mikewen/virtual-sense.dsp-hardware/AudioDSP/distinct_VS_ADSP.ods

Components | Quantity | To mount | Package | Value | Note
BTB1 | 1 | NO | Through Hole | KEYSTONE – 2466 | http://it.farnell.com/keystone/2466/battery-holder/dp/1702632
R41,R40 | 2 | NO | Resistor SMD 0603 | 10K
R49 | 1 | NO | Resistor SMD 0603 | 0
C16,C12,C10,C14 | 4 | NO | Capacitor ceramic SMD 0603 | 10u
C69 | 1 | NO | Radial Can – SMD | 100u | http://it.farnell.com/panasonic/eeeft0j101ar/cap-alu-elec-100uf-6-3v-smd/dp/2065951
P1,P6 | 2 | NO | Through Hole Headers 2x1 | TE Connectivity 2-1445098-2 | http://it.mouser.com/ProductDetail/TE-Connectivity/2-1445098-2/
P15 | 1 | NO | Through Hole Headers 6x1 | Molex 53014-0610 | http://www.molex.com/molex/products/listview.jsp?query=&offset=0&autoNav=1&sType=z&filter=&channel=Products
P16 | 1 | NO | Through Hole Headers 8x1 | Molex 53014-0810 | http://www.molex.com/molex/products/listview.jsp?query=&offset=0&autoNav=1&sType=z&filter=&channel=Products
P17,P18 | 2 | NO | Through Hole Headers 4x1 | Molex 53014-0410 | http://www.molex.com/molex/products/listview.jsp?query=&offset=0&autoNav=1&sType=z&filter=&channel=Products
P3,P4,P5 | 3 | NO | Through Hole Headers 2x1 | Molex 53014-0210 | http://www.molex.com/molex/products/listview.jsp?query=&offset=0&autoNav=1&sType=z&filter=&channel=Products
BTB2 | 1 | YES | Coin Cell Holder – 7.9mm | KEYSTONE – 2988 | http://it.farnell.com/keystone/2988/battery-contact-7-9mm-hear-aid/dp/1887934
C17,C2,C11,C41,C43,C30,C59,C58,C52,C53,C21,C7 | 12 | YES | Capacitor ceramic SMD 0805 | 10u
C18 | 1 | YES | Capacitor ceramic SMD 0805 | 4u7
C20,C1,C15,C29,C24,C26,C34,C36,C35,C61,C60,C65,C70,C48,C39,C8,C13,C66,C55,C56,C22,C19,C9,C44,C46,C33,C31,C38,C47,C45 | 30 | YES | Capacitor ceramic SMD 0603 | 100n
C25,C32,C67,C68,C40,C42 | 6 | YES | Capacitor ceramic SMD 0805 | 1u
C27,C28 | 2 | YES | Capacitor ceramic SMD 0603 | 33p
C37 | 1 | YES | Capacitor ceramic SMD 0603 | 10n
C4,C3,C6,C5 | 4 | YES | Capacitor ceramic SMD 0603 | 470n
C49,C50 | 2 | YES | Radial Can – SMD | 100u | http://it.farnell.com/panasonic/eeeft0j101ar/cap-alu-elec-100uf-6-3v-smd/dp/2065951
C51,C64 | 2 | YES | Capacitor ceramic SMD 1210 | 22u
C63,C62 | 2 | YES | Capacitor ceramic SMD 1206 | 2u2
D0,D1 | 2 | YES | LED SMD 0603 | 150060RS75000 - RED | http://katalog.we-online.de/led/datasheet/150060RS75000.pdf
D5 | 1 | YES | SOD-80 | ZMM5234B-7-F | http://it.mouser.com/ProductDetail/Vishay-Semiconductors/TZM5234B-GS08/
L1,L2 | 2 | YES | Inductor SMD 0805 | BLM21AG151SN1D
L12,L10,L11,L9 | 4 | YES | Inductor SMD 0805 | BLM21BB221SN1D
L3 | 1 | YES | Inductor SMD 0805 | BLM18AG601SN1D
L7,L6,L4,L8,L5 | 5 | YES | Inductor SMD 0603 | BLM18AG601SN1D
PB1,PB2,PB3 | 3 | YES | SMD Push Button | FSM2JSMA | http://it.mouser.com/ProductDetail/TE-Connectivity-Alcoswitch/FSM2JSMA/
R11,R14 | 2 | YES | Resistor SMD 0603 | 300
R23,R18,R20 | 3 | YES | Resistor SMD 0603 | 100K
R3,R13 | 2 | YES | Resistor SMD 0603 | 4K7
R31,R34,R33,R37,R39,R43,R45,R47,R36,R38,R42,R44,R46,R55,R57,R2,R17,R21,R22,R24,R19 | 21 | YES | Resistor SMD 0603 | 10K
R5,R4,R8,R6 | 4 | YES | Resistor SMD 0603 | 1K
R51,R50 | 2 | YES | Resistor SMD 0805 | 0
R54,R25,R48,R30,R26,R15,R58,R29,R1,R10,R9,R7 | 12 | YES | Resistor SMD 0603 | 0
R56,R27 | 2 | YES | Resistor SMD 0603 | 220
SD2,SD1 | 2 | YES | MCH_FCI-10067847-001 | FCI-10067847-001 | http://portal.fciconnect.com/Comergent//fci/drawing/10067847.pdf
SW1 | 1 | YES | Slide switch Through Hole | JS202011CQN | http://it.mouser.com/ProductDetail/CK-Components/JS202011CQN/
SW2 | 1 | YES | Slide switch SMD | JS202011SCQN | http://it.mouser.com/ProductDetail/CK-Components/JS202011SCQN/
U1 | 1 | YES | SOT23-5 | TPS76933 | http://it.farnell.com/texas-instruments/tps76933dbvt/ic-ldo-regulator-0-1a-10v-sot23/dp/8461538
U10 | 1 | YES | SOIC-8 (15mil Body Width) | SST25PF080B-80-4C-SAE | http://it.mouser.com/ProductDetail/Microchip-Technology/SST25PF080B-80-4C-SAE/
U13 | 1 | YES | OLed Through Hole | MIDAS – 2063209 | http://it.farnell.com/midas/mccog21605b6w-bnmlwi/lcd-cog-2x16-neg-stn-w-b-l-i2c/dp/2063209
U2 | 1 | YES | QFN-N32 | TLV320AIC3204 | http://it.farnell.com/texas-instruments/tlv320aic3204irhbt/ic-lp-audio-codec-1-8v-32qfn/dp/1689424
U3 | 1 | YES | DFN-6 | SI7020 | http://it.mouser.com/ProductDetail/Silicon-Labs/Si7020-A10-GM/
U4 | 1 | YES | 2.5 mm x 2 mm | ASDM1-12.000MHZ | http://it.mouser.com/ProductDetail/ABRACON/ASDM1-12000MHZ-LC-T/
U5 | 1 | YES | BGA-N144 | TMS320C5535AZHH10 | http://it.farnell.com/texas-instruments/tms320c5535azhh10/ic-dsp-c55x-fixed-point-144bga/dp/2076772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
U7 | 1 | YES | SOIC-8 | TPS77533D | http://it.mouser.com/ProductDetail/Texas-Instruments/TPS77533D/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
U8 | 1 | YES | SOIC | TPS2080D | http://it.farnell.com/texas-instruments/tps2080d/ic-dual-power-dist-sw-8-soic/dp/1755538?Ntt=tps2080d
U9 | 1 | YES | HTSSOP-20 EP | TPS60125PWP | http://it.mouser.com/ProductDetail/Texas-Instruments/TPS60125PWP/
USB1 | 1 | YES | micro USB SMD Connector | 10103594-0001LF | http://it.mouser.com/ProductDetail/FCI/10103594-0001LF/
X1 | 1 | YES | 4115 | DST410S 32.768KHz | http://www.compotek.de/fileadmin/data/Datenblaetter/DST410S-32.768k-9-20-E.pdf
