mikewen/virtual-sense.dsp-hardware/AudioDSP/distinct_VS-Idro.ods

Component | Quantity | Package | Value | Note
BTB2 | 1 | Coin Cell Holder - 7.9mm | KEYSTONE – 2988 | http://it.farnell.com/keystone/2988/battery-contact-7-9mm-hear-aid/dp/1887934
C1,C8,C9,C13,C15,C19,C20,C22,C24,C26,C29,C31,C33,C34,C35,C36,C38,C39,C44,C45,C46,C47,C48,C55,C56,C57,C60,C61,C65,C66,C70 | 31 | Capacitor ceramic SMD 0603 | 100n
C2,C7,C11,C17,C21,C30,C41,C43,C52,C53,C54,C58,C59 | 13 | Capacitor ceramic SMD 0805 | 10u
C3,C4,C5,C6 | 4 | Capacitor ceramic SMD 0603 | 470n
C10,C12,C14,C16,R40,R41,R49 | 7 | Capacitor ceramic SMD 0603 | NO
C18,C23 | 2 | Capacitor ceramic SMD 0805 | 4u7
C25,C32,C40,C42,C67,C68 | 6 | Capacitor ceramic SMD 0805 | 1u
C27,C28 | 2 | Capacitor ceramic SMD 0603 | 33p
C37 | 1 | Capacitor ceramic SMD 0603 | 10n
C49,C50 | 2 | Radial Can – SMD | 100u | http://it.farnell.com/panasonic/eeeft0j101ar/cap-alu-elec-100uf-6-3v-smd/dp/2065951
C51,C64 | 2 | Capacitor ceramic SMD 1210 | 22u
C62,C63 | 2 | Capacitor ceramic SMD 1206 | 2u2
C69 | 1 | Radial Can – SMD | NO
D0,D1 | 2 | LED SMD 0603 | 150060RS75000 - RED | http://katalog.we-online.de/led/datasheet/150060RS75000.pdf
D5 | 1 | SOD-80 | ZMM5234B-7-F | http://it.mouser.com/ProductDetail/Vishay-Semiconductors/TZM5234B-GS08/
L1,L2 | 2 | Inductor SMD 0805 | BLM21AG151SN1D
L3,L4,L5,L6,L7,L8 | 6 | Inductor SMD 0805 | BLM18AG601SN1D
L9,L10,L11,L12 | 4 | Inductor SMD 0805 | BLM21BB221SN1D
PB1,PB2,PB3 | 3 | SMD Pushbutton | FSM2JSMA | http://it.mouser.com/ProductDetail/TE-Connectivity-Alcoswitch/FSM2JSMA/
R1,R7,R9,R10,R12,R15,R25,R26,R29,R30,R35,R48,R50,R51,R54,R58 | 16 | Resistor SMD 0603 | 0
R2,R17,R19,R21,R22,R24,R31,R33,R34,R36,R37,R38,R39,R42,R43,R44,R45,R46,R47,R55,R57 | 21 | Resistor SMD 0603 | 10K
R3,R13 | 2 | Resistor SMD 0603 | 4K7
R4,R5,R6,R8 | 4 | Resistor SMD 0603 | 1K
R11,R14 | 2 | Resistor SMD 0603 | 300
R18,R20,R23 | 3 | Resistor SMD 0603 | 100K
R27,R56 | 2 | Resistor SMD 0603 | 220
SD1,SD2 | 2 | MCH_FCI-10067847-001 | FCI-10067847-001 | http://portal.fciconnect.com/Comergent//fci/drawing/10067847.pdf
SW1,SW2 | 2 | JS202011SCQN | JS202011SCQN | http://it.mouser.com/ProductDetail/CK-Components/JS202011SCQN/
U1 | 1 | SOT23-5 | TPS76933 | http://it.farnell.com/texas-instruments/tps76933dbvt/ic-ldo-regulator-0-1a-10v-sot23/dp/8461538
U2 | 1 | QFN-N32 | TLV320AIC3204 | http://it.farnell.com/texas-instruments/tlv320aic3204irhbt/ic-lp-audio-codec-1-8v-32qfn/dp/1689424
U3 | 1 | DFN-6 | SI7020 | http://it.mouser.com/ProductDetail/Silicon-Labs/Si7020-A10-GM/
U4 | 1 | 2.5 mm x 2 mm | ASDM1-12.000MHZ | http://it.mouser.com/ProductDetail/ABRACON/ASDM1-12000MHZ-LC-T/
U5 | 1 | BGA-N144 | TMS320C5535AZHH10 | http://it.farnell.com/texas-instruments/tms320c5535azhh10/ic-dsp-c55x-fixed-point-144bga/dp/2076772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
U7 | 1 | SOIC-8 | TPS77533D | http://it.mouser.com/ProductDetail/Texas-Instruments/TPS77533D/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
U8 | 1 | SOIC | TPS2080D | http://it.farnell.com/texas-instruments/tps2080d/ic-dual-power-dist-sw-8-soic/dp/1755538?Ntt=tps2080d
U9 | 1 | HTSSOP-20 EP | TPS60125PWP | http://it.mouser.com/ProductDetail/Texas-Instruments/TPS60125PWP/
U10 | 1 | SOIC-8 | SST25PF080B-80-4C-S2AE | http://it.mouser.com/ProductDetail/Microchip-Technology/SST25PF080B-80-4C-S2AE/
U11 | 1 | TH | 1144435 | http://it.farnell.com/fci/10018783-11110tlf/connettore-pci-2x18-vie/dp/1144435?Ntt=1144435
U13 | 1 | TH | 2063209 | http://it.farnell.com/midas/mccog21605b6w-bnmlwi/lcd-cog-2x16-neg-stn-w-b-l-i2c/dp/2063209
USB1 | 1 | micro USB connector | 10118194-0001LF | http://it.mouser.com/ProductDetail/FCI/10118194-0001LF/
X1 | 1 | 4115 | DST410S 32.768KHz | http://www.compotek.de/fileadmin/data/Datenblaetter/DST410S-32.768k-9-20-E.pdf
