mikewen/virtual-sense.dsp-hardware/AudioDSP/pdf/VirtualSense_ADSP.pdf

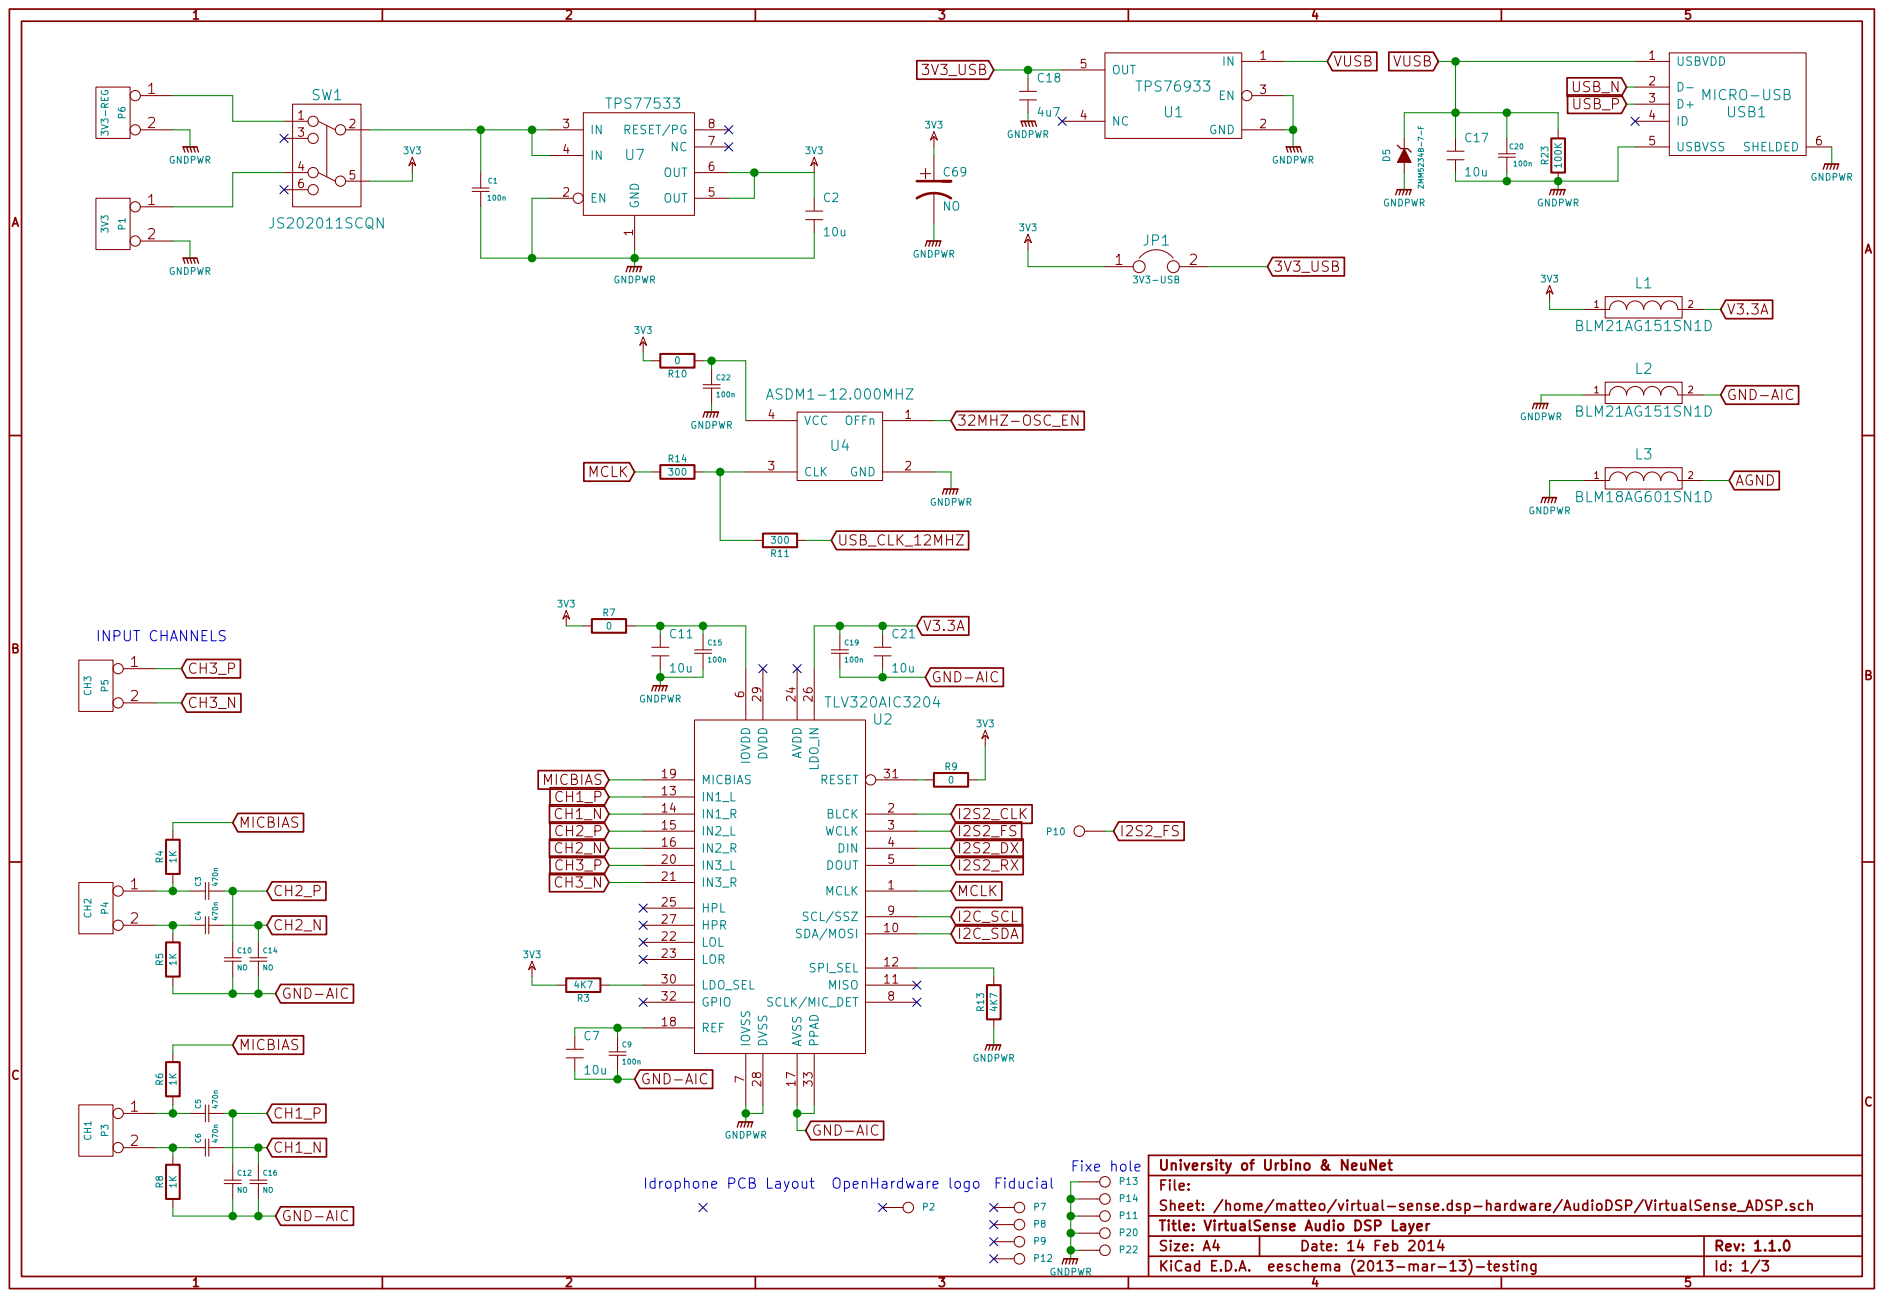
[picture p1: page 1]

7 SCLK/MIC_DET 8 SCL/SSZ 9 SDA/MOSI 10

C University of Urbino & NeuNet

Sheet: /home/matteo/virtual-sense.dsp-hardware/AudioDSP/VirtualSense_ADSP.sch File: Title: VirtualSense Audio DSP Layer

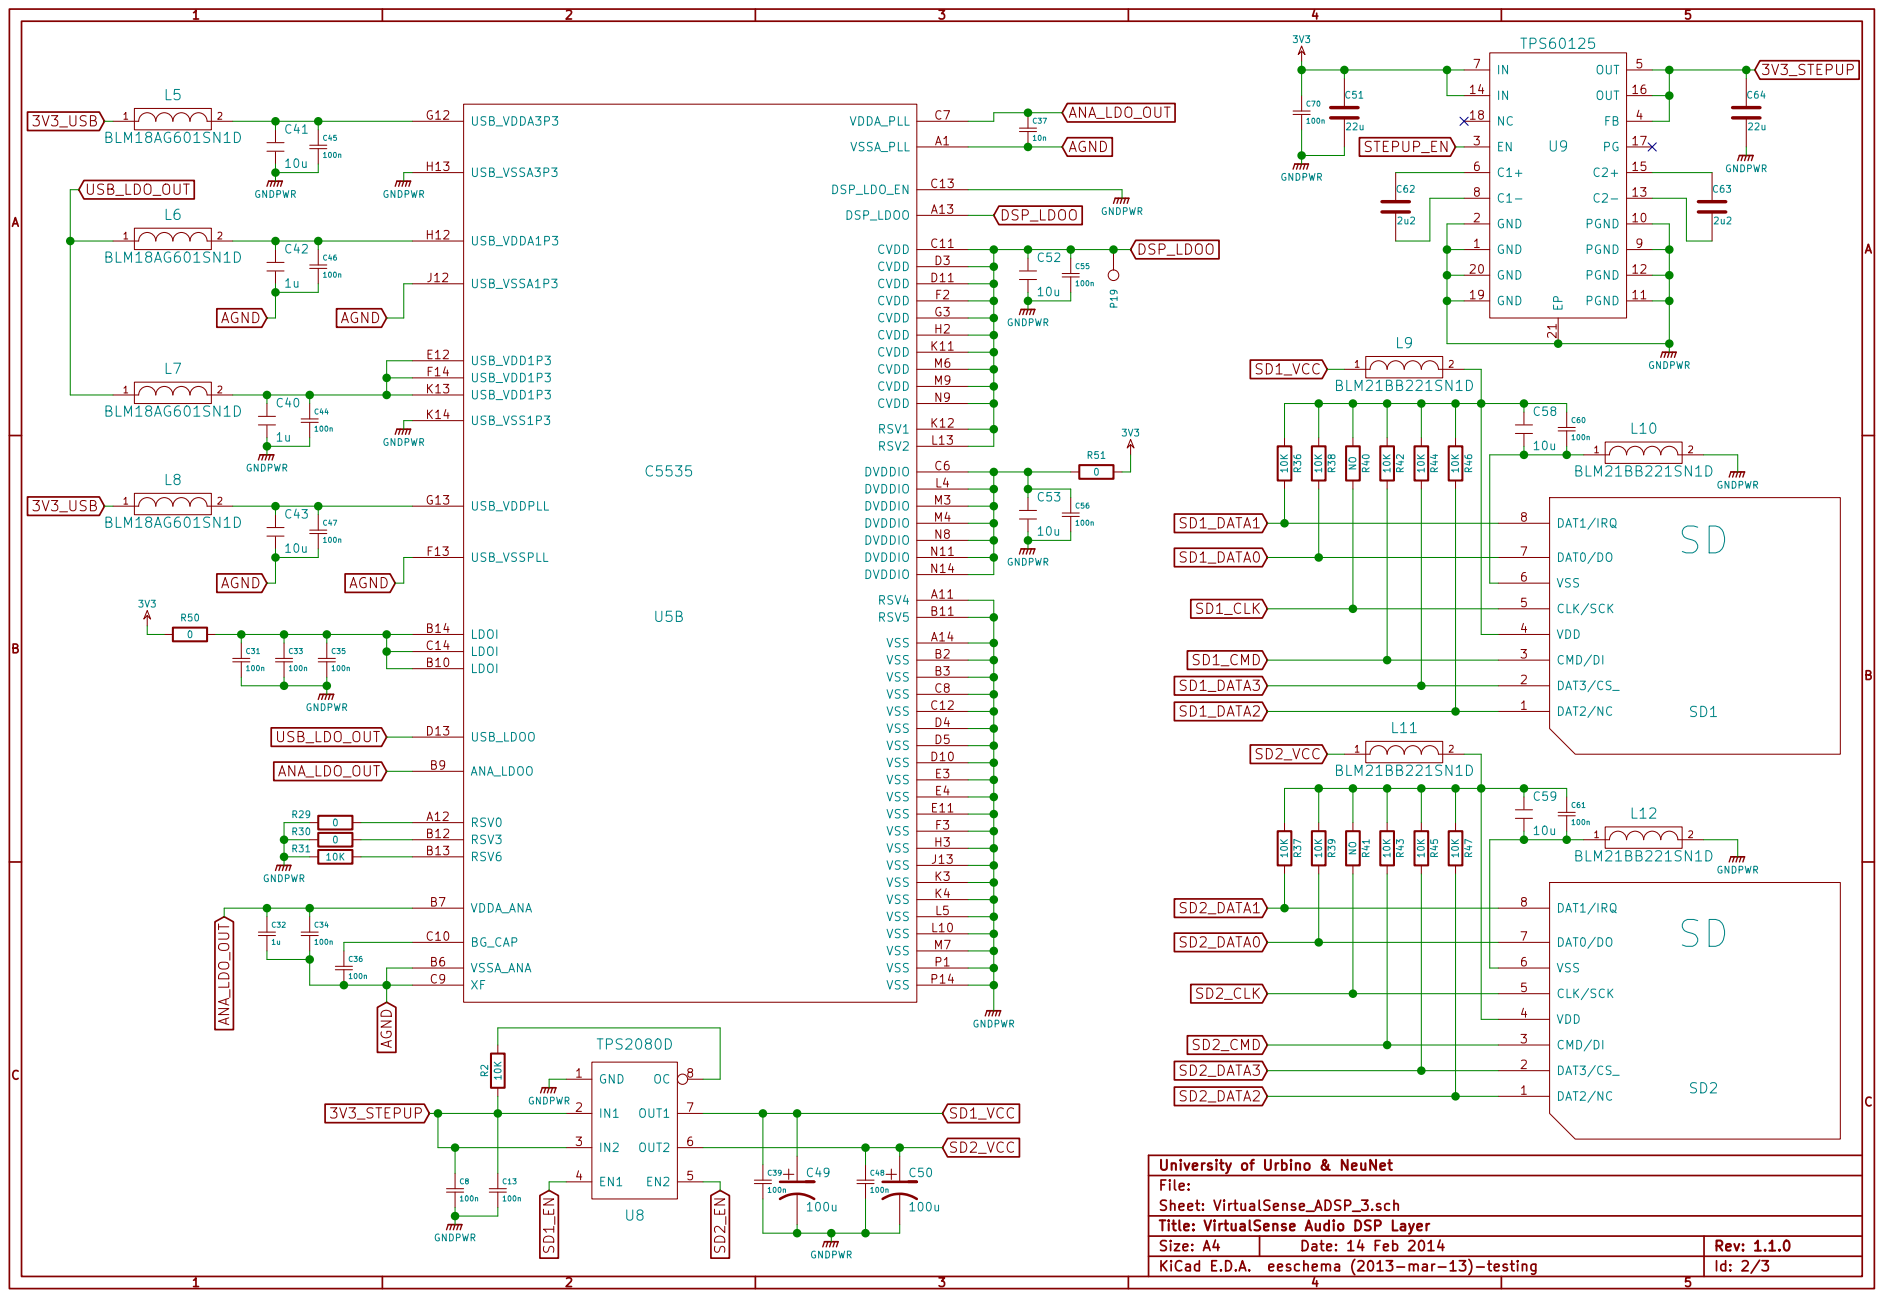
[picture p2: page 2]

Sheet: VirtualSense_ADSP_3.sch File: Title: VirtualSense Audio DSP Layer

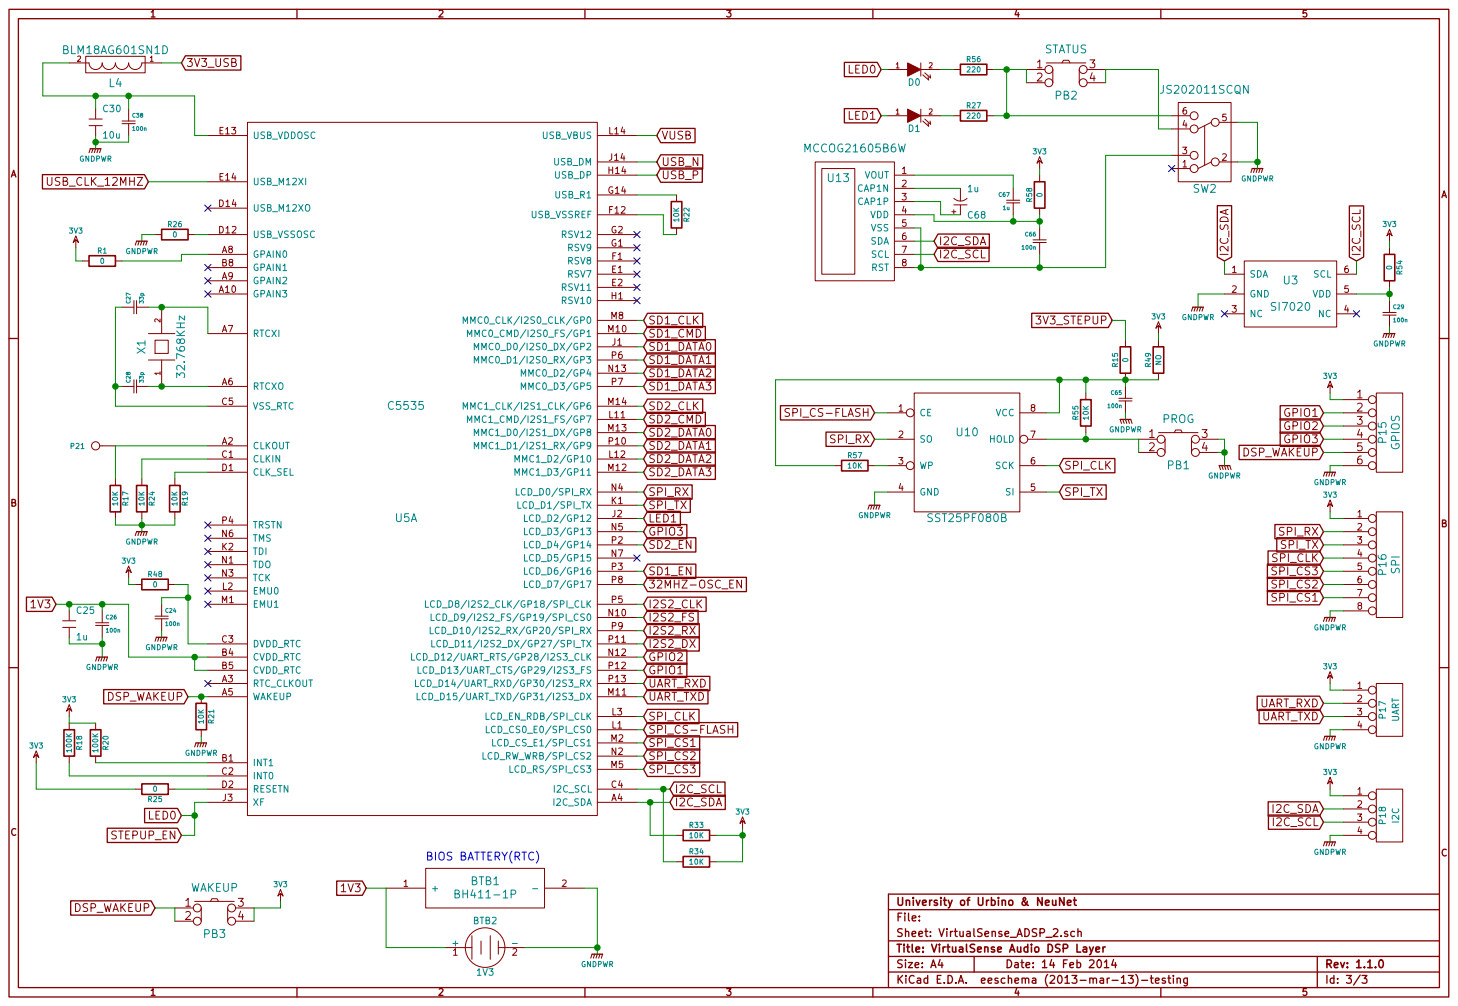
[picture p3: page 3]

C University of Urbino & NeuNet

Sheet: VirtualSense_ADSP_2.sch File: Title: VirtualSense Audio DSP Layer
