mikewen/virtual-sense.dsp-hardware/(list of files, drawings)

Other design files:
AudioDSP/VirtualSense_ADSP-test_clearance.dsn
AudioDSP/VirtualSense_ADSP.dsn
AudioDSP/VirtualSense_ADSP_r.dsn
