mikewen/virtual-sense.dsp-hardware/AudioDSP/VirtualSense_ADSP.sch

## KiCad design AudioDSP/VirtualSense_ADSP.sch (2014-05-29)

Schematic: VirtualSense_ADSP.sch

Parts:
C1, C9, C15, C19, C20, C22: 100n
C2, C7, C11, C17, C21: 10u
C3, C4, C5, C6: 470n
C10, C12, C14, C16, C69: NO
C18: 4u7
D5: ZMM5234B-7-F
JP1: 3V3-USB
L1, L2: BLM21AG151SN1D
L3: BLM18AG601SN1D
P1: 3V3
P2: DSP
P3: CH1
P4: CH2
P5: CH3
P6: 3V3-REG
P7, P8, P9, P11, P12, P13, P14, P20, P22: CONN_1
P10: AIC-CLK
R3, R13: 4K7
R4, R5, R6, R8: 1K
R7, R9, R10: 0
R11, R14: 300
R23: 100K
SW1: JS202011SCQN
U1: TPS76933
U2: TLV320AIC3204
U4: ASDM1-12.000MHZ
U7: TPS77533
USB1: MICRO-USB

Notes on the sheet:
Fixe hole
Fiducial
OpenHardware logo
INPUT CHANNELS
Idrophone PCB Layout
