mikewen/virtual-sense.dsp-hardware/AudioDSP/VirtualSense_ADSP_2.sch

## KiCad design AudioDSP/VirtualSense_ADSP_2.sch (2014-06-06)

Schematic: VirtualSense_ADSP_2.sch

Parts:
BTB1: BH411-1P
BTB2: 1V3
C24, C26, C29, C38, C65, C66: 100n
C25, C67, C68: 1u
C27, C28: 33p
C30: 10u
D0, D1: LED
L4: BLM18AG601SN1D
P15: GPIOS
P16: SPI
P17: UART
P18: I2C
P21: DSP-CLKOUT
PB1: PROG
PB2: STATUS
PB3: WAKEUP
R1, R15, R25, R26, R48, R54, R58: 0
R17, R19, R21, R22, R24, R33, R34, R55, R57: 10K
R18, R20: 100K
R27, R56: 220
R49: NO
SW2: JS202011SCQN
U3: SI7020
U5: C5535
U10: SST25PF080B
U13: MCCOG21605B6W
X1: 32.768KHz

Notes on the sheet:
BIOS BATTERY(RTC)
