mikewen/virtual-sense.dsp-hardware/AudioDSP/VirtualSense_ADSP_3.sch

## KiCad design AudioDSP/VirtualSense_ADSP_3.sch (2014-05-29)

Schematic: VirtualSense_ADSP_3.sch

Parts:
C8, C13, C31, C33, C34, C35, C36, C39, C44, C45, C46, C47, C48, C55, C56, C60, C61, C70: 100n
C32, C40, C42: 1u
C37: 10n
C41, C43, C52, C53, C58, C59: 10u
C49, C50: 100u
C51, C64: 22u
C62, C63: 2u2
L5, L6, L7, L8: BLM18AG601SN1D
L9, L10, L11, L12: BLM21BB221SN1D
P19: DSP-LDOO
R2, R31, R36, R37, R38, R39, R42, R43, R44, R45, R46, R47: 10K
R29, R30, R50, R51: 0
R40, R41: NO
SD1, SD2: SD
U5: C5535
U8: TPS2080D
U9: TPS60125
