mikewen/virtual-sense.dsp-hardware/(commit log)

2014-02-13 create VirtualSenseDSP project
    [VirtualSense_ADSP-test_clearance.dsn, VirtualSense_ADSP.brd, VirtualSense_ADSP.dsn, VirtualSense_ADSP.sch, VirtualSense_ADSP_2.sch, VirtualSense_ADSP_3.sch, antenne.brd]
2014-02-27 create schematics, components footprints, board layout.
    [VirtualSense_ADSP.brd, VirtualSense_ADSP.sch, VirtualSense_ADSP_2.sch, VirtualSense_ADSP_3.sch]
2014-03-06 add too many libraries on schematics, board disposal almolst complete, hope that will be routed
    [VirtualSense_ADSP.brd, VirtualSense_ADSP.sch, VirtualSense_ADSP_2.sch, VirtualSense_ADSP_3.sch]
2014-05-19 Schematic and board complete (add tps60125 charge-pump, tps77533 LDO regolator, oled).
    [VirtualSense_ADSP (copy).brd, VirtualSense_ADSP.csv, VirtualSense_ADSP.dsn, VirtualSense_ADSP.sch, VirtualSense_ADSP_2.sch, VirtualSense_ADSP_3.sch, VirtualSense_ADSP_r.dsn, distinct_VS-Idro.ods]
2014-05-29 gerber and schematic modified, sendt to MCE
    [VirtualSense_ADSP-test_clearance.dsn, VirtualSense_ADSP.brd, VirtualSense_ADSP.csv, VirtualSense_ADSP.sch, VirtualSense_ADSP_2.sch, VirtualSense_ADSP_3.sch, distinct_VS-Idro.ods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]
2014-06-05 Modified USB tracks width, back silks references and routing of DSP wakeup button (PB3). Second sent to MCE.
    [VirtualSense_ADSP.brd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]
2014-06-06 Modified routing of U6 enable pin to XF pin (J3) of DSP. Left unconnected previously used pin (N7).
    [VirtualSense_ADSP.brd, VirtualSense_ADSP_2.sch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]
2014-08-28 Updated schematic pdf document at last version
    [VirtualSense_ADSP.brd, VirtualSense_ADSP.csv, distinct_VS_ADSP.ods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]
